spiricom/Inductive_Fretboard/new_fretboard_rev4/new_fretboard_rev6/new_fretboard_rev6.kicad_pcb

## KiCad design new_fretboard_rev4/new_fretboard_rev6/new_fretboard_rev6.kicad_pcb (2026-09-25)

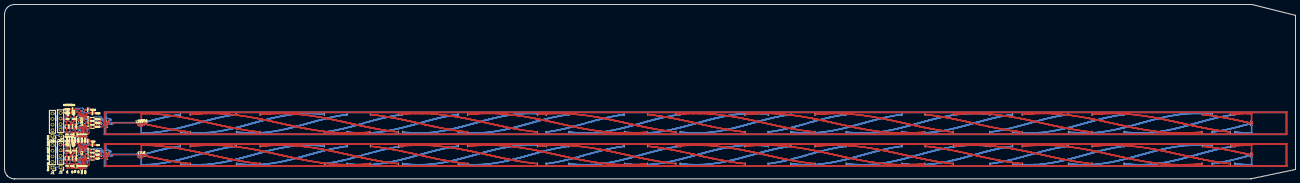
[picture p1: board new_fretboard_rev6.kicad_pcb from above]

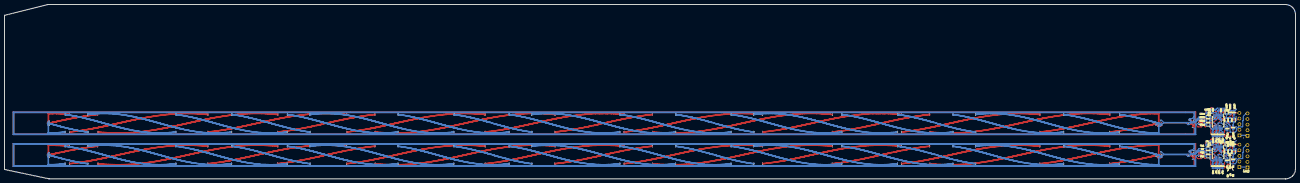
[picture p2: board new_fretboard_rev6.kicad_pcb from below]

Board: 4 copper layers, 585.0 x 79.0 mm, 96 parts (46 on the bottom side), 61 nets.

Parts:
C1, C2, C3, C4, C301, C302, C303, C304: 6.8nF; C_0603
C5, C6, C13, C14, C305, C306, C313, C314: 100nF; C_0603
C7, C8, C307, C308: 1000pF; C_0603
C9, C10, C309, C310: 470nF; C_0603
C11, C12, C311, C312: 1uF; C_0603
C15, C16, C17, C18, C315, C316, C317, C318: 10pF; C_0603
C19, C20, C21, C22, C319, C320, C321, C322: 680PF; C_0603
J1, J301: Conn_01x06; PinHeader_1x05_P2.54mm_Vertical
J2, J302: Conn_01x05; PinHeader_1x05_P2.54mm_Vertical
L1, L2, L3, L4, L5, L6, L7, L8, L301, L302, L303, L304, L305, L306, L307, L308: PCB L; jumper_tiny
R1, R2, R301, R302: 221R; R_0603
R3, R4, R5, R6, R303, R304, R305, R306: 10k; R_0603
R7, R8, R307, R308: 4.7R; R_0603
R9, R10, R11, R12, R13, R14, R309, R310, R311, R312, R313, R314: 10R; R_0603
U1, U2, U301, U302: LX3302AQPW_TSSOP-14; TSSOP-14_4.4x5mm_P0.65mm

Connections:
/ch1/COS_A: L7.1, R13.2
/ch1/COS_A_PRE_RES: C18.2, R13.1, U2.10 (CL2)
/ch1/COS_B: L5.1, R11.2
/ch1/COS_B_PRE_RES: C17.2, R11.1, U1.10 (CL2)
/ch1/IO1_A: J2.5, R4.1, U2.7 (IO1)
/ch1/IO1_B: J1.5, R3.1, U1.7 (IO1)
/ch1/IO2_A: C4.2, R2.2, R6.1, U2.6 (IO2)
/ch1/IO2_A_FILT: C2.2, J2.4, R2.1
/ch1/IO2_B: C3.2, R1.2, R5.1, U1.6 (IO2)
/ch1/IO2_B_FILT: C1.2, J1.4, R1.1
/ch1/IO3_A: J2.3, U2.3 (IO3)
/ch1/IO3_B: J1.3, U1.3 (IO3)
/ch1/OSC_CCW_A: C22.2, L4.1, U2.12 (OSC2)
/ch1/OSC_CCW_B: C20.2, L3.1, U1.12 (OSC2)
/ch1/OSC_CW_A: C21.2, L2.1, U2.13 (OSC1)
/ch1/OSC_CW_B: C19.2, L1.1, U1.13 (OSC1)
/ch1/OSC_RTN_A: L2.2, L4.2, R10.1
/ch1/OSC_RTN_B: L1.2, L3.2, R9.1
/ch1/SIN_A: L8.1, R14.2
/ch1/SIN_A_PRE_RES: C16.2, R14.1, U2.8 (CL1)
/ch1/SIN_B: L6.1, R12.2
/ch1/SIN_B_PRE_RES: C15.2, R12.1, U1.8 (CL1)
/ch1/SUB_A: C14.1, U2.11 (SUB)
/ch1/SUB_B: C13.1, U1.11 (SUB)
/ch1/VDD1_A: C12.2, C14.2, U2.5 (VDD)
/ch1/VDD1_B: C11.2, C13.2, U1.5 (VDD)
/ch1/VIN1_A: C8.2, C10.2, R4.2, R6.2, R8.2, R10.2, U2.4 (VIN)
/ch1/VIN1_B: C7.2, C9.2, R3.2, R5.2, R7.2, R9.2, U1.4 (VIN)
/ch1/VIN_A: C6.2, J2.2, R8.1
/ch1/VIN_B: C5.2, J1.2, R7.1
/ch2/COS_A: L307.1, R313.2
/ch2/COS_A_PRE_RES: C318.2, R313.1, U302.10 (CL2)
/ch2/COS_B: L305.1, R311.2
/ch2/COS_B_PRE_RES: C317.2, R311.1, U301.10 (CL2)
/ch2/IO1_A: J302.5, R304.1, U302.7 (IO1)
/ch2/IO1_B: J301.5, R303.1, U301.7 (IO1)
/ch2/IO2_A: C304.2, R302.2, R306.1, U302.6 (IO2)
/ch2/IO2_A_FILT: C302.2, J302.4, R302.1
/ch2/IO2_B: C303.2, R301.2, R305.1, U301.6 (IO2)
/ch2/IO2_B_FILT: C301.2, J301.4, R301.1
/ch2/IO3_A: J302.3, U302.3 (IO3)
/ch2/IO3_B: J301.3, U301.3 (IO3)
/ch2/OSC_CCW_A: C322.2, L304.1, U302.12 (OSC2)
/ch2/OSC_CCW_B: C320.2, L303.1, U301.12 (OSC2)
/ch2/OSC_CW_A: C321.2, L302.1, U302.13 (OSC1)
/ch2/OSC_CW_B: C319.2, L301.1, U301.13 (OSC1)
/ch2/OSC_RTN_A: L302.2, L304.2, R310.1
/ch2/OSC_RTN_B: L301.2, L303.2, R309.1
/ch2/SIN_A: L308.1, R314.2
/ch2/SIN_A_PRE_RES: C316.2, R314.1, U302.8 (CL1)
/ch2/SIN_B: L306.1, R312.2
/ch2/SIN_B_PRE_RES: C315.2, R312.1, U301.8 (CL1)
/ch2/SUB_A: C314.1, U302.11 (SUB)
/ch2/SUB_B: C313.1, U301.11 (SUB)
/ch2/VDD1_A: C312.2, C314.2, U302.5 (VDD)
/ch2/VDD1_B: C311.2, C313.2, U301.5 (VDD)
/ch2/VIN1_A: C308.2, C310.2, R304.2, R306.2, R308.2, R310.2, U302.4 (VIN)
/ch2/VIN1_B: C307.2, C309.2, R303.2, R305.2, R307.2, R309.2, U301.4 (VIN)
/ch2/VIN_A: C306.2, J302.2, R308.1
/ch2/VIN_B: C305.2, J301.2, R307.1
GND1: C1.1, C2.1, C3.1, C4.1, C5.1, C6.1, C7.1, C8.1, C9.1, C10.1, C11.1, C12.1, C15.1, C16.1, C17.1, C18.1, C19.1, C20.1, C21.1, C22.1, C301.1, C302.1, C303.1, C304.1, C305.1, C306.1, C307.1, C308.1, C309.1, C310.1, C311.1, C312.1, C315.1, C316.1, C317.1, C318.1, C319.1, C320.1, C321.1, C322.1, J1.1, J2.1, J301.1, J302.1, L5.2, L6.2, L7.2, L8.2, L305.2, L306.2, L307.2, L308.2, U1.2 (GND), U1.9 (GNDCL), U2.2 (GND), U2.9 (GNDCL), U301.2 (GND), U301.9 (GNDCL), U302.2 (GND), U302.9 (GNDCL)
