spiricom/Inductive_Fretboard/new_fretboard_rev4/new_fretboard_rev4/new_fretboard_rev4.kicad_pcb

## KiCad design new_fretboard_rev4/new_fretboard_rev4/new_fretboard_rev4.kicad_pcb (2026-09-25, an earlier design)

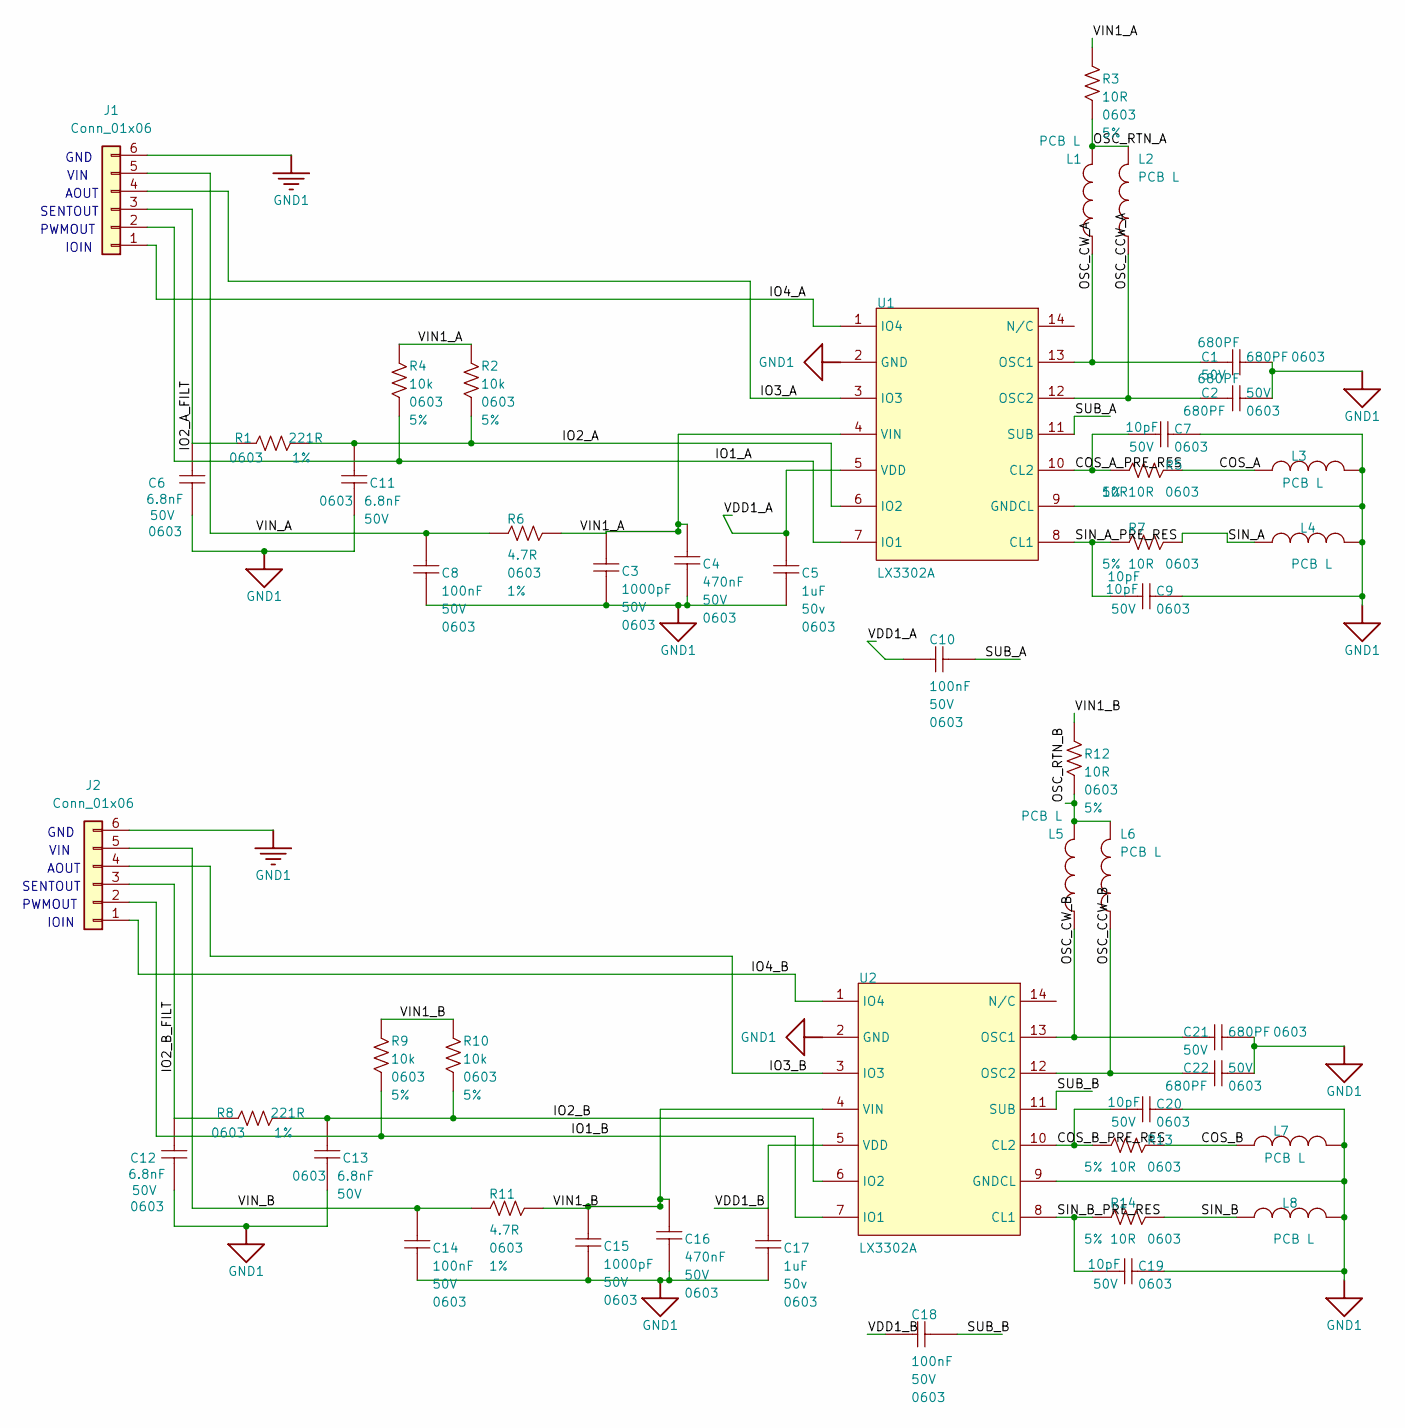
[picture p3: schematic new_fretboard_rev4.kicad_sch]

Parts:
C1, C2, C21, C22: 680PF; C_0603; VOLTAGE 50V; TOLERANCE ±10%; MANUFACTURER PART NUMBE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 C0603C681K5GAC7867
C3, C15: 1000pF; C_0603; VOLTAGE 50V; TOLERANCE 10%; MANUFACTURER PART NUMBE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 C1608X7R1H102K
C4, C16: 470nF; C_0603; VOLTAGE 50V; TOLERANCE 10%; MANUFACTURER PART NUMBE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 UMK107B7474KA-TR
C5, C17: 1uF; C_0603; VOLTAGE 50v; TOLERANCE 10%; MANUFACTURER PART NUMBE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 UMK107AB7105KA-T
C6, C11, C12, C13: 6.8nF; C_0603; VOLTAGE 50V; TOLERANCE 5%; MANUFACTURER PART NUMBE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 CGA3E2C0G1H682J080AA
C7, C9, C19, C20: 10pF; C_0603; VOLTAGE 50V; TOLERANCE 10%; MANUFACTURER PART NUMBE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 C0402C100K5RAC7867
C8, C10, C14, C18: 100nF; C_0603; VOLTAGE 50V; TOLERANCE 10%; MANUFACTURER PART NUMBE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 06035C104K4T2A
J1, J2: Conn_01x06; PinHeader_1x06_P2.54mm_Vertical; Part Number 1-0601FBV0T
L1, L2, L3, L4, L5, L6, L7, L8: PCB L; jumper_tiny
R1, R8: 221R; R_0603; TOLERANCE 1%; VOLTAGE 75V; MANUFACTURER PART NUMBE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 ERJ-3EKF2210V
R2, R4, R9, R10: 10k; R_0603; TOLERANCE 5%; VOLTAGE 75V; MANUFACTURER PART NUMBE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 ERJ-3GEYJ103V
R3, R5, R7, R12, R13, R14: 10R; R_0603; TOLERANCE 5%; VOLTAGE 75V; MANUFACTURER PART NUMBE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 ERJ-3GEYJ100V
R6, R11: 4.7R; R_0603; TOLERANCE 1%; MANUFACTURER PART NUMBE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 ERJ-3RQF4R7V
U1, U2: LX3302AQPW_TSSOP-14; TSSOP-14_4.4x5mm_P0.65mm; MANUFACTURER PART NUMBE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 LX3302AQPW

Connections:
/COS_A: L3.1, R5.2
/COS_A_PRE_RES: C7.2, R5.1, U1.10 (CL2)
/COS_B: L7.1, R13.2
/COS_B_PRE_RES: C20.2, R13.1, U2.10 (CL2)
/IO1_A: J1.2, R4.1, U1.7 (IO1)
/IO1_B: J2.2, R9.1, U2.7 (IO1)
/IO2_A: C11.2, R1.2, R2.1, U1.6 (IO2)
/IO2_A_FILT: C6.2, J1.3, R1.1
/IO2_B: C13.2, R8.2, R10.1, U2.6 (IO2)
/IO2_B_FILT: C12.2, J2.3, R8.1
/IO3_A: J1.4, U1.3 (IO3)
/IO3_B: J2.4, U2.3 (IO3)
/IO4_A: J1.1, U1.1 (IO4)
/IO4_B: J2.1, U2.1 (IO4)
/OSC_CCW_A: C2.2, L2.1, U1.12 (OSC2)
/OSC_CCW_B: C22.2, L6.1, U2.12 (OSC2)
/OSC_CW_A: C1.2, L1.1, U1.13 (OSC1)
/OSC_CW_B: C21.2, L5.1, U2.13 (OSC1)
/OSC_RTN_A: L1.2, L2.2, R3.1
/OSC_RTN_B: L5.2, L6.2, R12.1
/SIN_A: L4.1, R7.2
/SIN_A_PRE_RES: C9.2, R7.1, U1.8 (CL1)
/SIN_B: L8.1, R14.2
/SIN_B_PRE_RES: C19.2, R14.1, U2.8 (CL1)
/SUB_A: C10.1, U1.11 (SUB)
/SUB_B: C18.1, U2.11 (SUB)
/VDD1_A: C5.2, C10.2, U1.5 (VDD)
/VDD1_B: C17.2, C18.2, U2.5 (VDD)
/VIN1_A: C3.2, C4.2, R2.2, R3.2, R4.2, R6.2, U1.4 (VIN)
/VIN1_B: C15.2, C16.2, R9.2, R10.2, R11.2, R12.2, U2.4 (VIN)
/VIN_A: C8.2, J1.5, R6.1
/VIN_B: C14.2, J2.5, R11.1
GND1: C1.1, C2.1, C3.1, C4.1, C5.1, C6.1, C7.1, C8.1, C9.1, C11.1, C12.1, C13.1, C14.1, C15.1, C16.1, C17.1, C19.1, C20.1, C21.1, C22.1, J1.6, J2.6, L3.2, L4.2, L7.2, L8.2, U1.2 (GND), U1.9 (GNDCL), U2.2 (GND), U2.9 (GNDCL)

Notes on the sheet:
VIN
IOIN
AOUT
GND
SENTOUT
PWMOUT

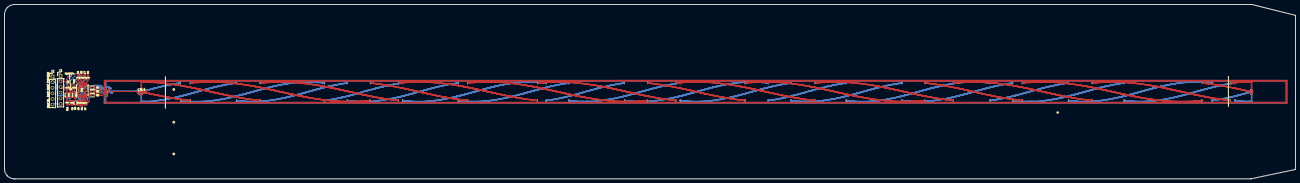
[picture p4: board new_fretboard_rev4.kicad_pcb from above]

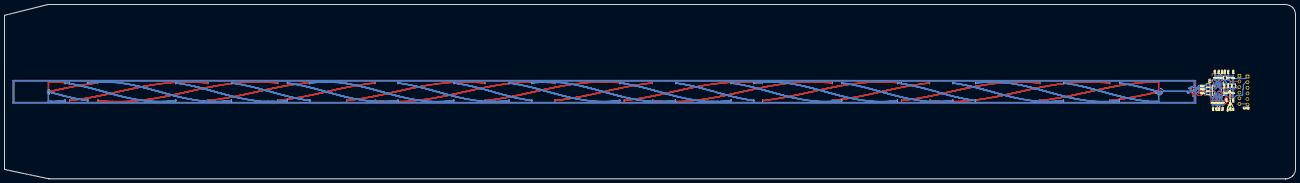
[picture p5: board new_fretboard_rev4.kicad_pcb from below]

Board: 4 copper layers, 585.0 x 79.0 mm, 48 parts (23 on the bottom side), 33 nets.
