spiricom/Inductive_Fretboard/new_fretboard_stm32h7/new_fretboard_stm32h7.ioc

Mcu.UserName=STM32H750IBKx
PA1.Signal=S_TIM2_CH2
PA3.Signal=S_TIM2_CH4
PA5.Signal=S_TIM2_CH1_ETR
PB1.Signal=S_TIM3_CH4
PB5.Signal=S_TIM3_CH2
PB6.Signal=S_TIM4_CH1
PB7.Signal=S_TIM4_CH2
PB8.Signal=S_TIM4_CH3
PC10.Signal=UART4_TX
PC11.Signal=UART4_RX
PC8.Signal=S_TIM3_CH3
