spiricom/Inductive_Fretboard/(commit log)

2026-09-23 initial commit, nets are named wrong
    [new_fretboard_rev3-2.kicad_pcb, new_fretboard_rev3-3.kicad_pcb, new_fretboard_rev4.kicad_pcb, new_fretboard_rev4.kicad_sch]
2026-09-24 sinA and cosA correct, and sinB correct
    [new_fretboard_rev4.kicad_pcb]
2026-09-24 possibly correct net names for coils
    [new_fretboard_rev4.kicad_pcb]
2026-09-24 updating net names of rest of circuit
    [new_fretboard_rev4.kicad_pcb, new_fretboard_rev4.kicad_sch]
2026-09-24 part footprints chosen
    [new_fretboard_rev4.kicad_pcb, new_fretboard_rev4.kicad_sch]
2026-09-24 added new footprint jumpers
    [new_fretboard_rev4.kicad_pcb, new_fretboard_rev4.kicad_sch]
2026-09-24 partway through routing top
    [new_fretboard_rev4.kicad_pcb, new_fretboard_rev4.kicad_sch]
2026-09-24 top layer routed, starting bottom layer
    [new_fretboard_rev4.kicad_pcb]
2026-09-24 close to done routing bottom
    [new_fretboard_rev4.kicad_pcb]
2026-09-24 in good shape, all routed, no errors. Still single sensor strip, about to add other channels
    [new_fretboard_rev4.kicad_pcb, new_fretboard_rev4.kicad_sch]
2026-09-25 trying multichannel, reannotating
    [new_fretboard_rev4.kicad_pcb, new_fretboard_rev4.kicad_sch, new_fretboard_rev5.kicad_pcb, new_fretboard_rev5.kicad_sch, new_fretboard_rev6.kicad_pcb, new_fretboard_rev6.kicad_sch]
2026-09-25 finished routing one channel. passes ERC. about to import second channel
    [new_fretboard_rev4.kicad_pcb, new_fretboard_rev6.kicad_pcb]
2026-09-25 two channels done
    [new_fretboard_rev4.kicad_sch, new_fretboard_rev6.kicad_pcb, new_fretboard_rev6.kicad_sch]
2026-09-25 fully routed all channels, about to add tilts
    [new_fretboard_rev4.kicad_sch, new_fretboard_rev6.kicad_sch]
2026-09-25 fully routed and tilted. Missing ground guards between and microcontroller connection, and power input.
2026-09-25 channels are done, working on microcontroller, daisy, and power junctions. getting heirarchical pin stuff sorted.
    [new_fretboard_rev4.kicad_sch, new_fretboard_rev6.kicad_sch]
2026-09-25 power in schematic, about to route power and sent wires
    [new_fretboard_rev4.kicad_sch, new_fretboard_rev6.kicad_sch]
2026-09-26 everything except cleaning up silkscreen done
    [new_fretboard_rev6.kicad_sch]
2026-09-26 finished, about to export gerbers
    [new_fretboard_rev6.kicad_sch]
2026-09-28 initial submission for Feb, just got an email that I need to increase spacing between tracks to at least 4.5mil
    [new_fretboard_rev6-B_Cu.gbr, new_fretboard_rev6-B_Mask.gbr, new_fretboard_rev6-B_Paste.gbr, new_fretboard_rev6-B_Silkscreen.gbr, new_fretboard_rev6-Edge_Cuts.gbr, new_fretboard_rev6-F_Cu.gbr, new_fretboard_rev6-F_Mask.gbr, new_fretboard_rev6-F_Paste.gbr]
2026-09-29 edited inner coils to increase spacing on bottom sensor, about to copy to others
2026-09-29 all routing fixed, just added power cap
    [new_fretboard_rev6.kicad_sch]
2026-09-29 revision 6.1 finished
    [new_fretboard_rev6.kicad_sch]
